CPBPILOT/MotionSim/BOM.xlsx

Item | Qty | Link (May be Affiliate) | Notes
Electronics
Raspberry Pi 4 | 1 | https://amzn.to/4gDeqRJ
Teensy 4.0 | 1 | https://amzn.to/4h26auC
MPU6050 | 1 | https://amzn.to/3DHh3n9
Level Shifter (Only if using LED) | 1 | https://amzn.to/3DGJHoi
5V LED Strip | 1 | https://amzn.to/4j0shDi
JST Connectors (Optional but makes wiring easier) | 1 | https://amzn.to/4j26Rpf
Terminal Blocks (Optional but makes wiring easier) | 1 | https://amzn.to/4gACqVC
Custom PCB (Limited Stock Available) | 1
USB Flight Stick / Throttle (Most should work) | 1 | https://amzn.to/3BJ2AXf
USB Rudder Pedals (Most should work) | 1 | https://amzn.to/3BWKVLD
20:1 NEMA 21 Gearbox | 2 | https://amzn.to/4iXhycP
NEMA 21 Closed Loop Stepper Motor Kit | 2 | https://www.omc-stepperonline.com/ts-series-3-0-nm-424-92oz-in-1-axis-closed-loop-stepper-cnc-kit-nema-23-motor-driver-1-cl57t-s30a-v41
NEMA 21 Motor Shaft Adapter | 2 | https://amzn.to/3PhDD8q
Motor Shaft Hub | 2 | https://amzn.to/3W463Gx | Many versions exist of this hub. Steel or aluminum should would
Gearbox Double Shaft | 2 | https://amzn.to/40mkeJW
Chair Structure
3/4" Plywood |  | Local Hardware Store
1/2" Plywood |  | Local Hardware Store
Screws |  | Local Hardware Store
Heim Joints |  | https://amzn.to/4jpR4Rm | 3/8-24 Female Thread Right Hand
Connecting Rod |  | https://www.mcmaster.com/98842A031/ | 3/8 x 24 - 2 sections at least 400mm
Angle Iron |  | Local Hardware Store
T Nuts |  | https://amzn.to/42f8U3v
Pack of spacers for Heim Joints |  | https://amzn.to/4g4bUCX | 1/2" OD x 3/8" ID 0.5" length
Pack of Bolts for Mounting Heim Joints: |  | https://amzn.to/3WrSz7X
3/8 NyLock Nuts |  | https://amzn.to/4ar7t3P
Other (Optional)
Buttkicker |  | https://amzn.to/3Q2x4ah
Amp for Buttkicker |  | https://www.amazon.com/gp/product/B07MR6YCQ1/ref=ppx_yo_dt_b_search_asin_title?ie=UTF8&psc=1
