CPBPILOT/MotionSim/(commit log)

2025-01-19 Documentation Added
    [BOM.xlsx]
2025-04-16 uncommented printing inputs
    Cleaned up code for using accel mode this should be ready for testing
